MichaelMIL/raspi-looper/(list of files, cad)

Other CAD files:
Config/settings.prt
